Elecrow-RD/CrowPanel-Advanced-9inch-ESP32-P4-HMI-AI-Display-1024x600-IPS-Touch-Screen/3D file/ESP32-P4-9_0-inch-20251230.stp

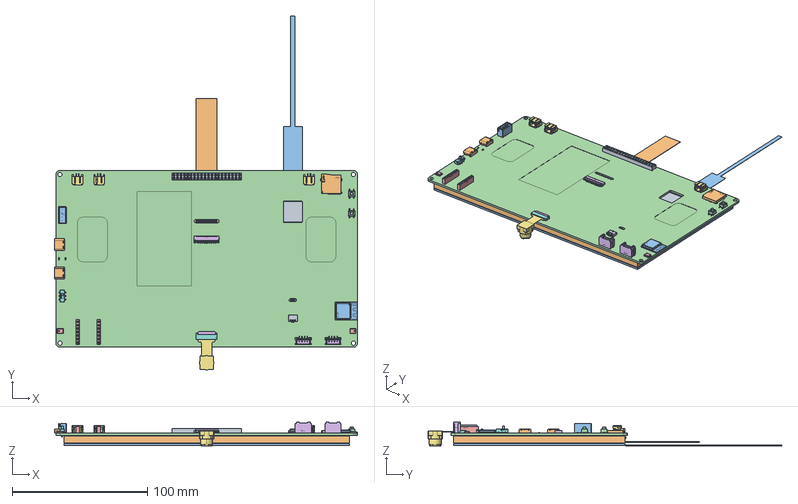
[picture p23: CAD file, 2026-01-28]
3D file/ESP32-P4-9_0-inch-20251230.stp
223.7 x 261.2 x 17.5 mm
LCD-9CUN
TP-9CUN
PCBA-9CUN
FPC1_FPC-SMD_P0_50-24P_QCHF-SM
H1_HDR-SMD_40P-P2_54-V-F-R2-C20
USB-C-SMD_TYPE-C-6PIN-2MD x 2
CN2_CONN-TH_4P-P2_50_4PIN_CONN
LED x 2
HDR-SMD_7P-P2_54_HX-PM2_54-1X7P x 2
U4_CONN-SMD_4P-P2_00 x 2
CONN-SMD_2P-P2_00_BX-PH2_0-2PWT x 3
SW-SMD_MST22D18G2_SW-SMD_MST22D
FPC-SMD_P0_50-6P_QCHF-SM-H2_0_1
TF-SMD
WIFIM-SMD_61P-L16_6-W13_2-P0_80
SW-SMD_4P-L4_5-W4_5-P3_00 x 2
MIC-SMD_6P-L4_7-W3_8-P1_65-TL_M x 2
CONN-SMD_AFC24-S30FIC-00_CONN-S
AS-AG638A32M1-25
