Elecrow-RD/CrowPanel-Advanced-9inch-ESP32-P4-HMI-AI-Display-1024x600-IPS-Touch-Screen/example/V1.2/Upgrade P4 to C6 firmware/CrowPanel_Advance_ESP32-P4 Display_Firmware_Upgrade_Guide-ESP_IDF platform.pdf

## Tutorial on Upgrading the C6 Firmware

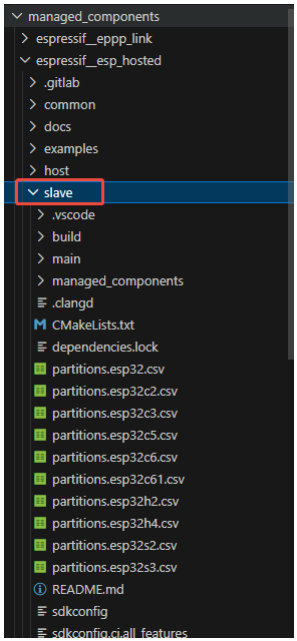
[picture p24: figure]

After compilation, a default network_adapter.bin file is generated in the build folder.

## via P4

First, select a version of the Hosted component. Here, we’ll choose version V2.12.3. The “slave” folder within the component contains the slave project. After selecting the ESP32-C6 chip, you can proceed to compile.

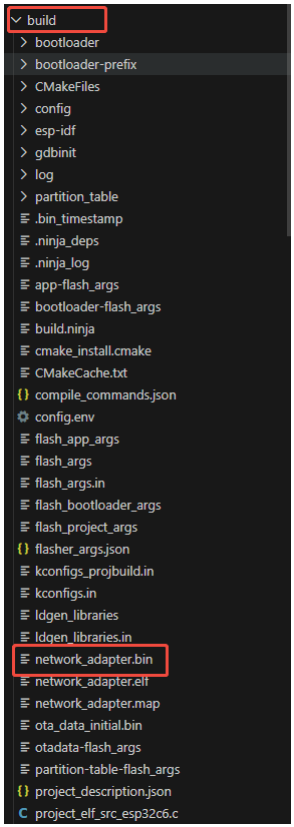
[picture p25: figure]

The 'host_performs_slave_ota' folder in the Hosted component is the OTA update project for the P4.

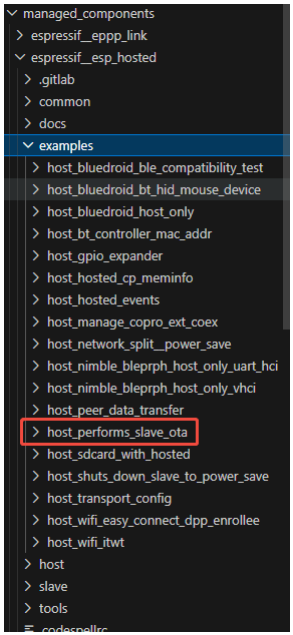
[picture p26: figure]

Add the following content to the 'sdkconfig.defaults' folder in the 'host_performs_slave_ota' project. Compile after modifying the default Hosted configuration. If the 'sdkconfig' file has already been generated, you can also make changes in 'menuconfig'.

# P4 chip version select

CONFIG_ESP32P4_SELECTS_REV_LESS_V3=y

# Host Slave OTA config

CONFIG_OTA_METHOD_LITTLEFS=y

CONFIG_ESP_HOSTED_PRIV_SDIO_PIN_CLK_SLOT_1=18 CONFIG_ESP_HOSTED_PRIV_SDIO_PIN_D0_SLOT_1=17 CONFIG_ESP_HOSTED_PRIV_SDIO_PIN_D1_4BIT_BUS_SLOT _1=16
CONFIG_ESP_HOSTED_PRIV_SDIO_PIN_D2_4BIT_BUS_SLOT _1=15
CONFIG_ESP_HOSTED_PRIV_SDIO_PIN_D3_4BIT_BUS_SLOT _1=14
CONFIG_ESP_HOSTED_SDIO_GPIO_RESET_SLAVE=32 5inch V1.0
CONFIG_ESP_HOSTED_SDIO_SLOT_1=y CONFIG_ESP_HOSTED_SDIO_4_BIT_BUS=y

Pin assignments vary by hardware version # Hosted slave config

7、9、10.1inch V1.0

CONFIG_ESP_HOSTED_SDIO_1_BIT_BUS=y CONFIG_ESP_HOSTED_SDIO_BUS_WIDTH=1 CONFIG_ESP_HOSTED_SDIO_CLOCK_FREQ_KHZ=40000 CONFIG_ESP_HOSTED_PRIV_SDIO_PIN_CMD_SLOT_1=19 CONFIG_ESP_HOSTED_PRIV_SDIO_PIN_CLK_SLOT_1=18 CONFIG_ESP_HOSTED_PRIV_SDIO_PIN_D0_SLOT_1=14 CONFIG_ESP_HOSTED_PRIV_SDIO_PIN_D1_1BIT_BUS_SLOT _1=15
CONFIG_ESP_HOSTED_SDIO_GPIO_RESET_SLAVE=32

7、9、10.1inch V1.1

CONFIG_ESP_HOSTED_SDIO_SLOT_1=y CONFIG_ESP_HOSTED_SDIO_4_BIT_BUS=y CONFIG_ESP_HOSTED_SDIO_CLOCK_FREQ_KHZ=40000 CONFIG_ESP_HOSTED_PRIV_SDIO_PIN_CMD_SLOT_1=19

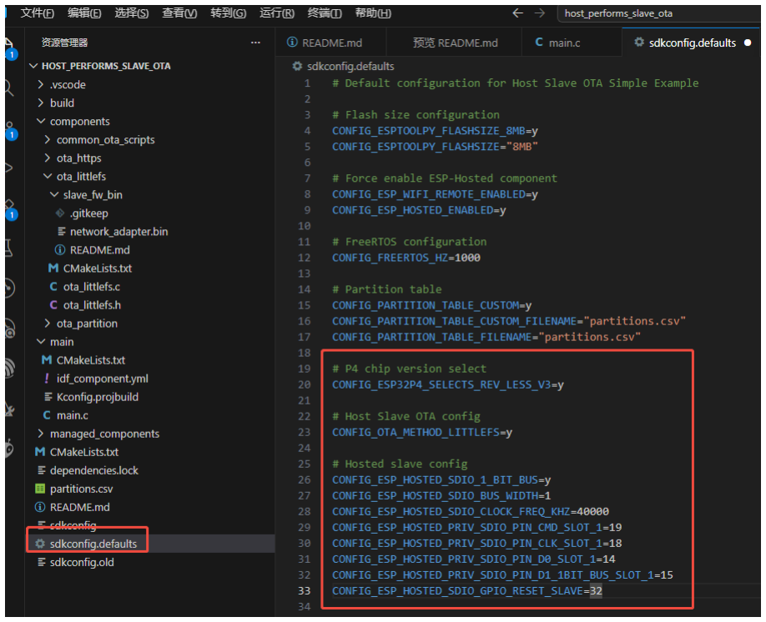
[picture p27: figure]

Place the network_adapter.bin firmware generated by the slave
project | into | the | corresponding | folder | in | the
host_performs_slave_ota project.

CONFIG_ESP_HOSTED_SDIO_CLOCK_FREQ_KHZ=40000 CONFIG_ESP_HOSTED_PRIV_SDIO_PIN_CMD_SLOT_1=54 CONFIG_ESP_HOSTED_PRIV_SDIO_PIN_CLK_SLOT_1=53 CONFIG_ESP_HOSTED_PRIV_SDIO_PIN_D0_SLOT_1=52 CONFIG_ESP_HOSTED_PRIV_SDIO_PIN_D1_4BIT_BUS_SLOT _1=51
CONFIG_ESP_HOSTED_PRIV_SDIO_PIN_D2_4BIT_BUS_SLOT _1=50
CONFIG_ESP_HOSTED_PRIV_SDIO_PIN_D3_4BIT_BUS_SLOT _1=49
CONFIG_ESP_HOSTED_SDIO_GPIO_RESET_SLAVE=20

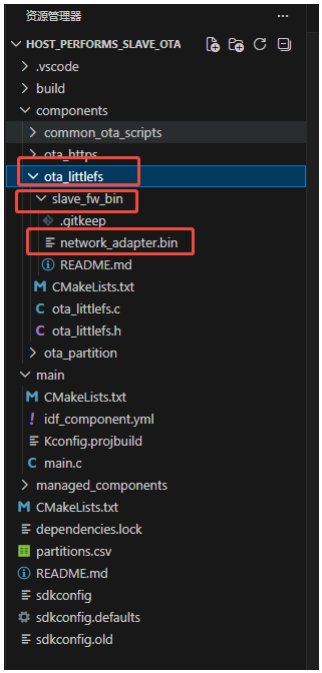
[picture p28: figure]

After | that, | select | the | ESP32-P4 | chip, | compile | the
host_performs_slave_ota project, and upload it to the ESP32-P4 Advance Board. Once the program runs, it will perform an OTA update of the C6 firmware.

Regarding the 1-bit and 4-bit options:

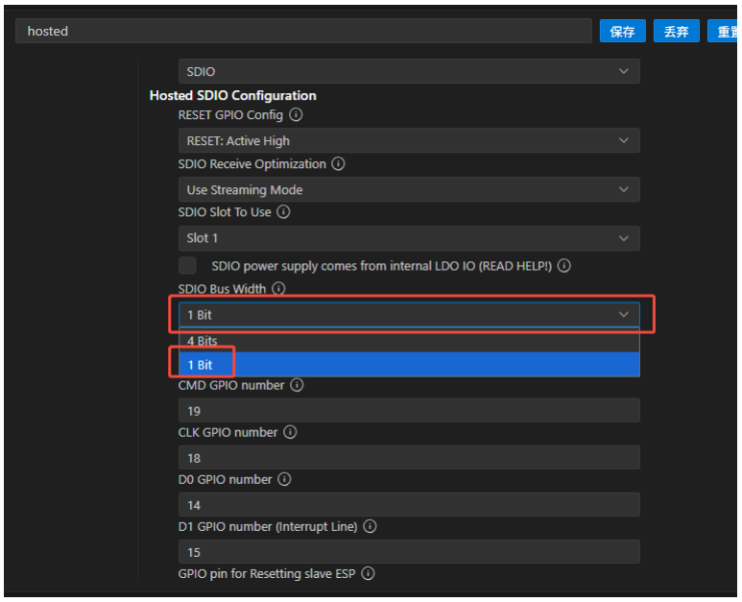
[picture p29: figure]
