Elecrow-RD/CrowPanel-Advanced-9inch-ESP32-P4-HMI-AI-Display-1024x600-IPS-Touch-Screen/Eagle_SCH&PCB/1.1/ESP32-P4 Display 9.0 inch V1.1.pdf

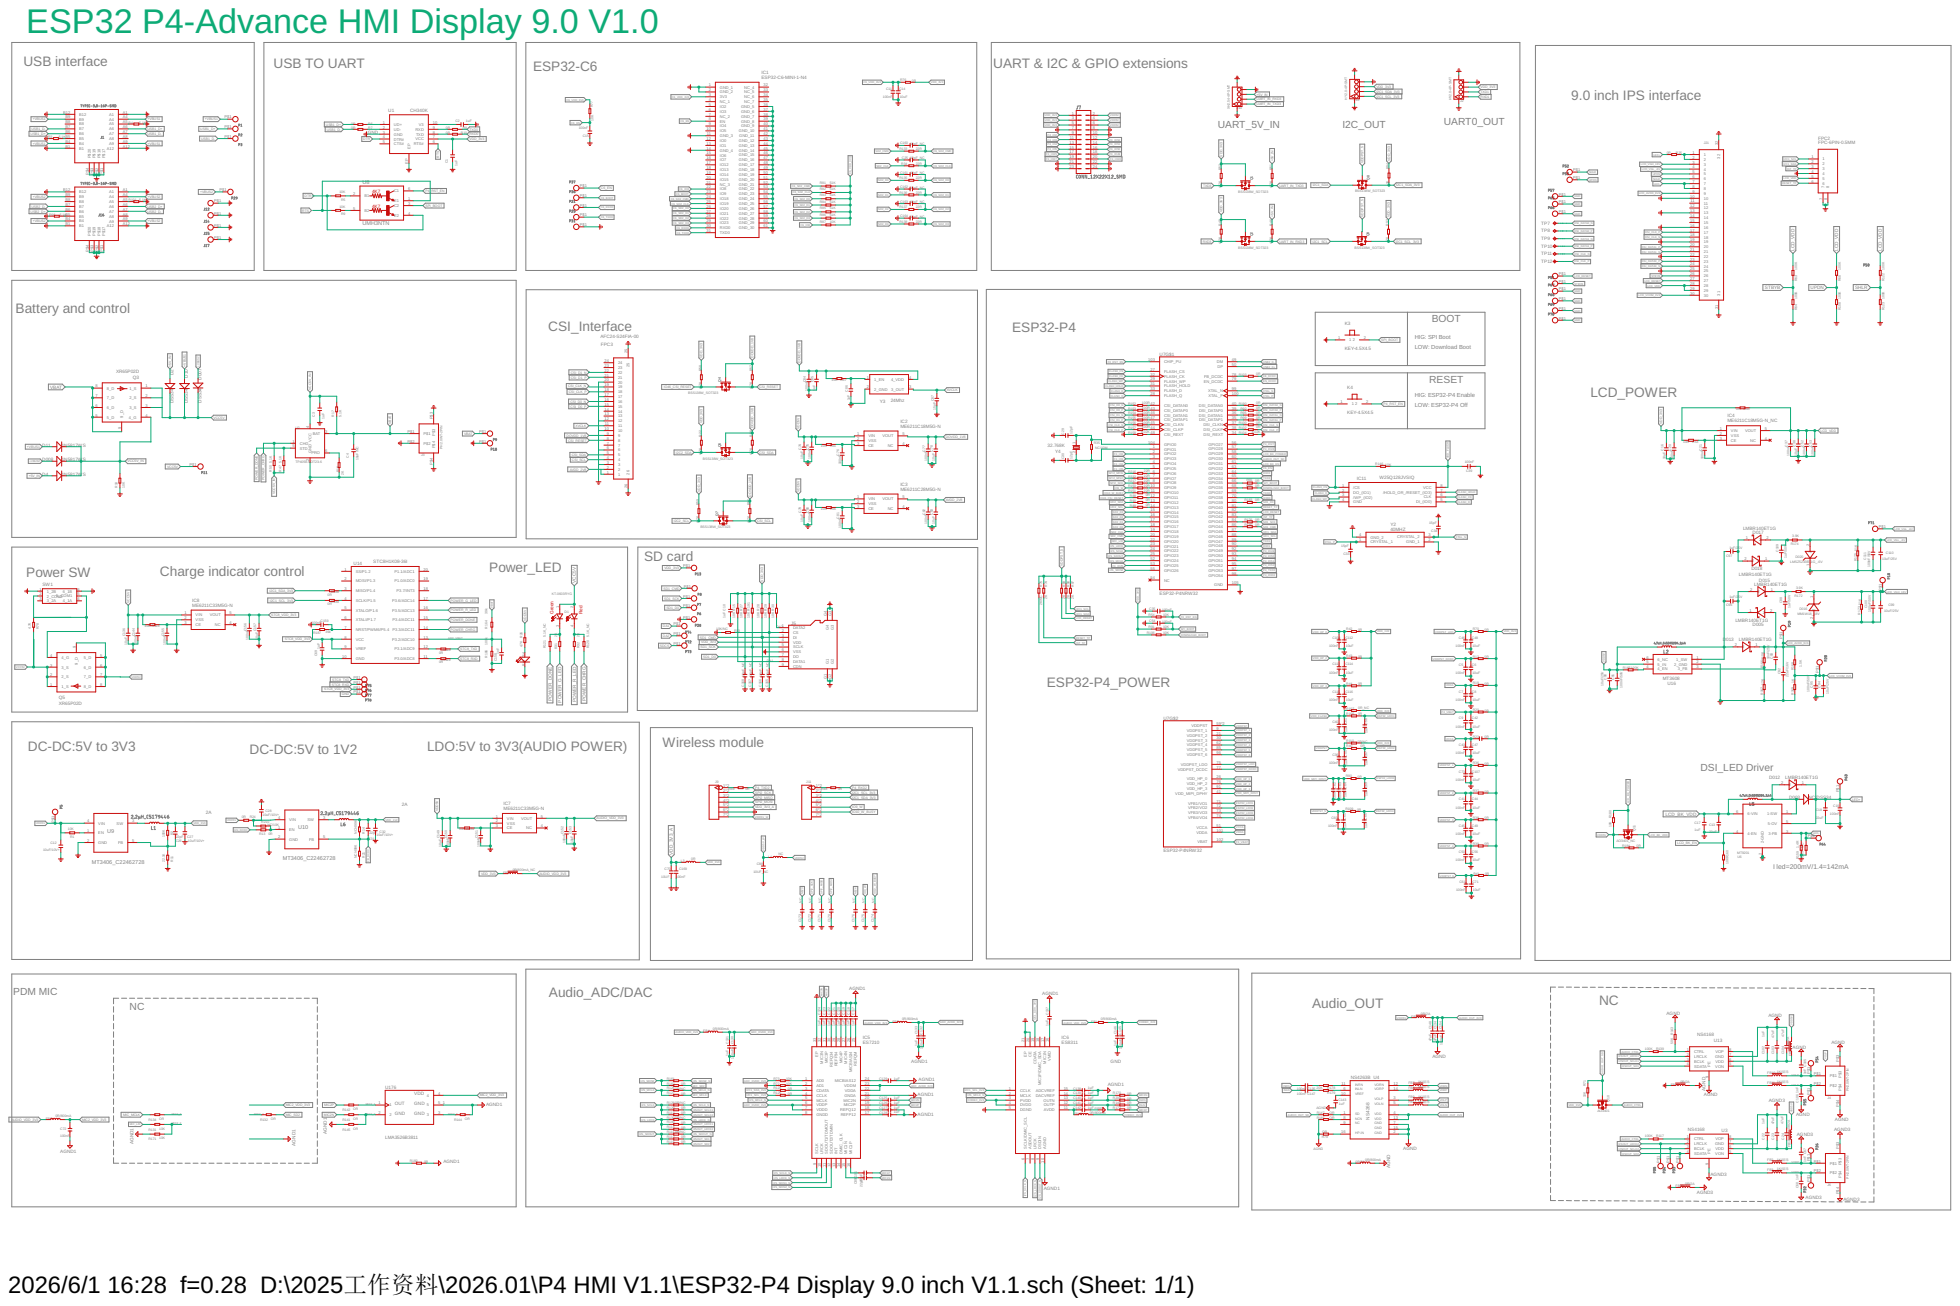
[picture p32: page 1]

HIG: SPI Boot LOW: Download Boot HIG: ESP32-P4 Enable

LDO:5V to 3V3(AUDIO POWER)

2026/6/1 16:28 f=0.28 D:\2025工作资料\2026.01\P4 HMI V1.1\ESP32-P4 Display 9.0 inch V1.1.sch (Sheet: 1/1)
