Elecrow-RD/CrowPanel-Advanced-9inch-ESP32-P4-HMI-AI-Display-1024x600-IPS-Touch-Screen/Eagle_SCH&PCB/1.2/ESP32-P4 Display 9.0 inch V1.2.pdf

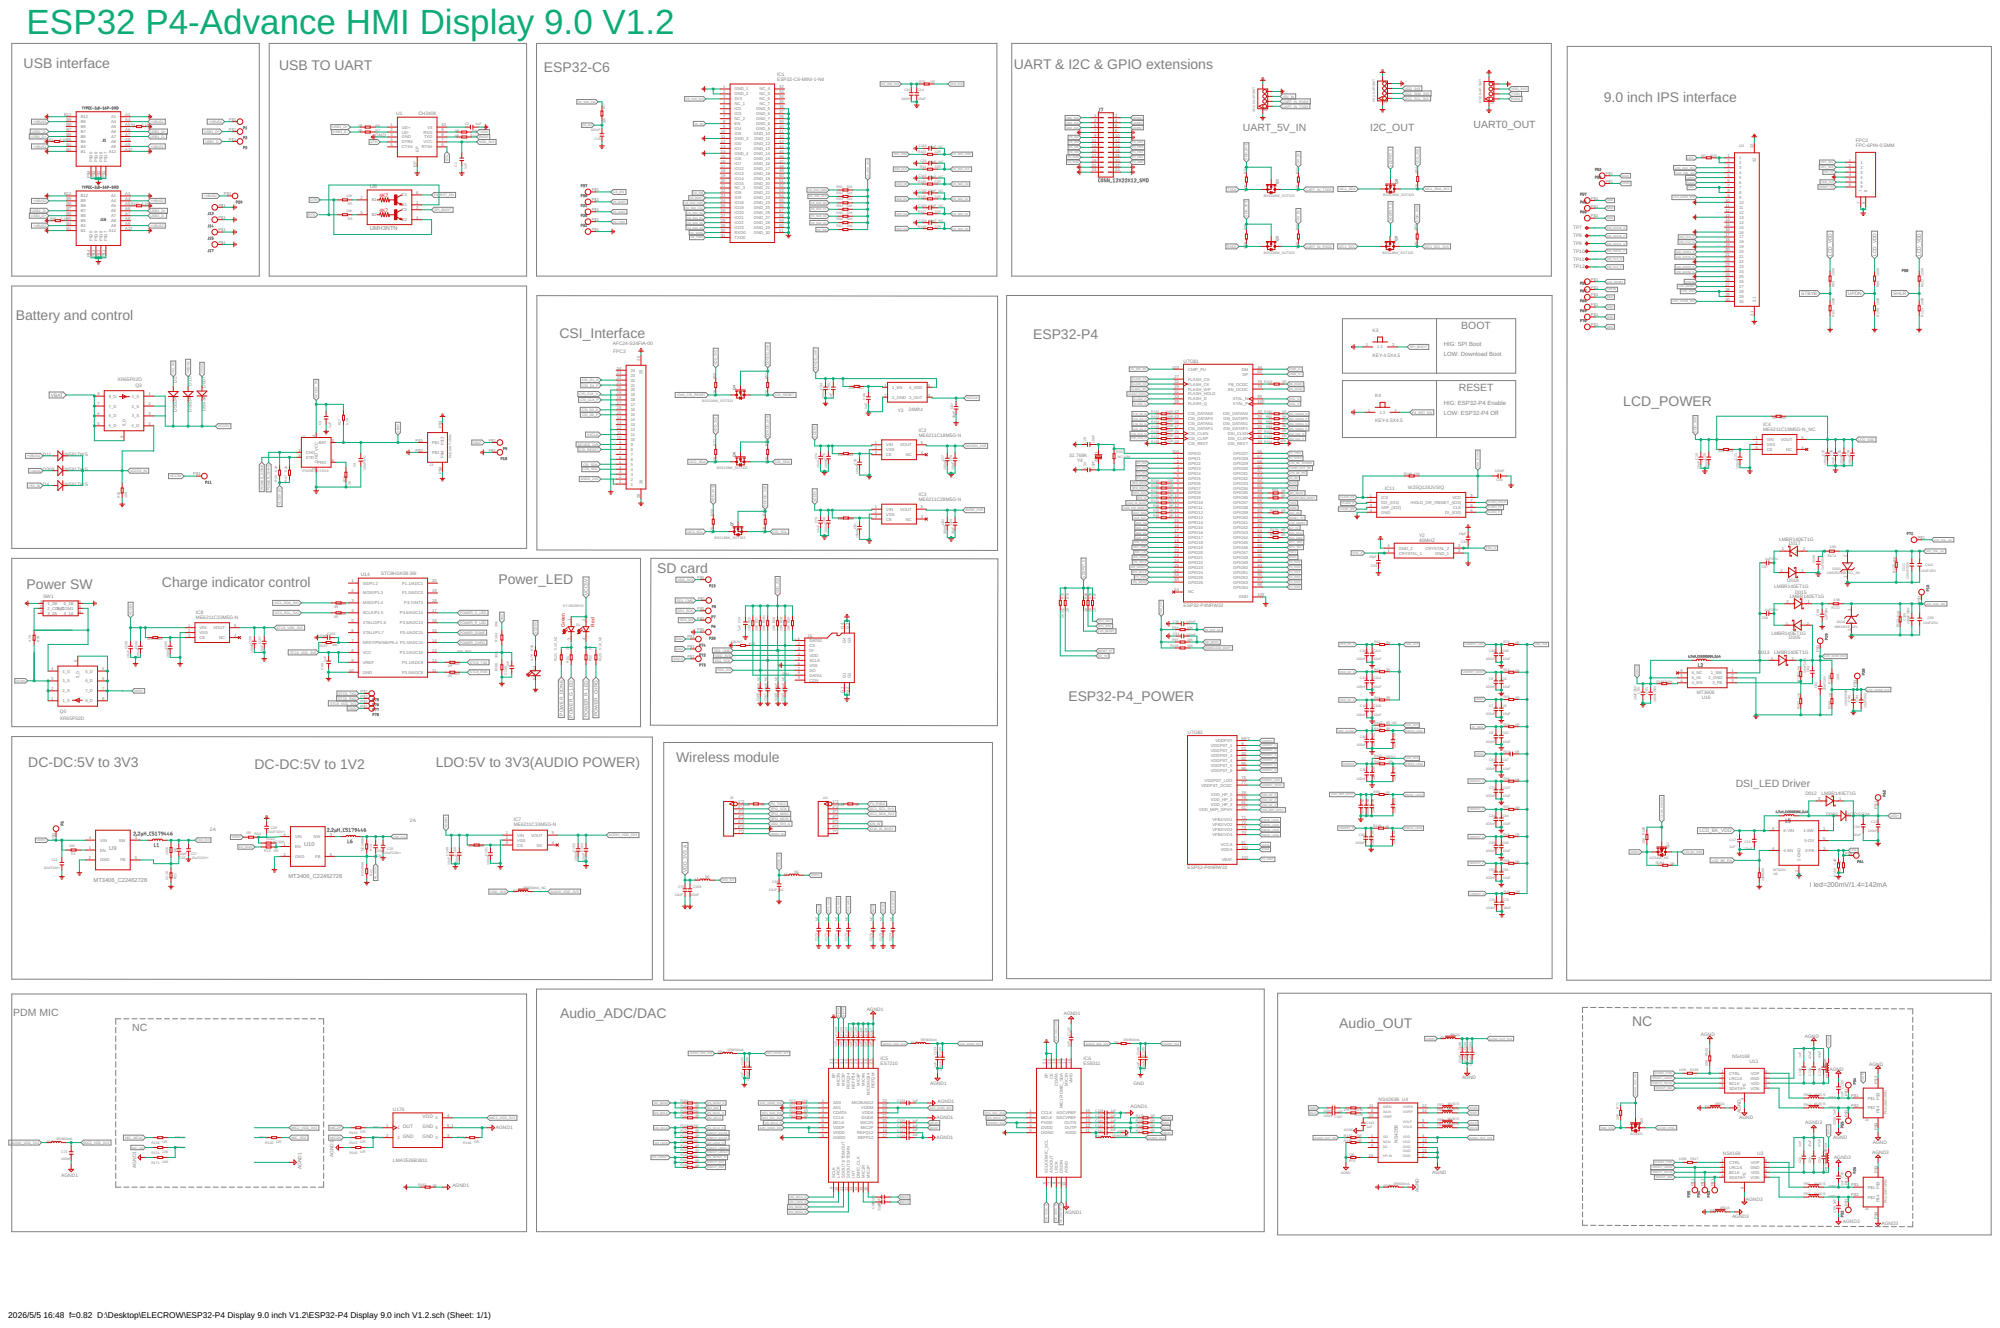
[picture p33: page 1]

LDO:5V to 3V3(AUDIO POWER)

2026/5/5 16:48 f=0.82 D:\Desktop\ELECROW\ESP32-P4 Display 9.0 inch V1.2\ESP32-P4 Display 9.0 inch V1.2.sch (Sheet: 1/1)
