Elecrow-RD/CrowPanel-Advanced-9inch-ESP32-P4-HMI-AI-Display-1024x600-IPS-Touch-Screen/Eagle_SCH&PCB/1.0/ESP32-P4 Display 9.0 inch V1.0-PDF.pdf

UART_5V_IN | I2C_OUT | UART0_OUT

### CH340K

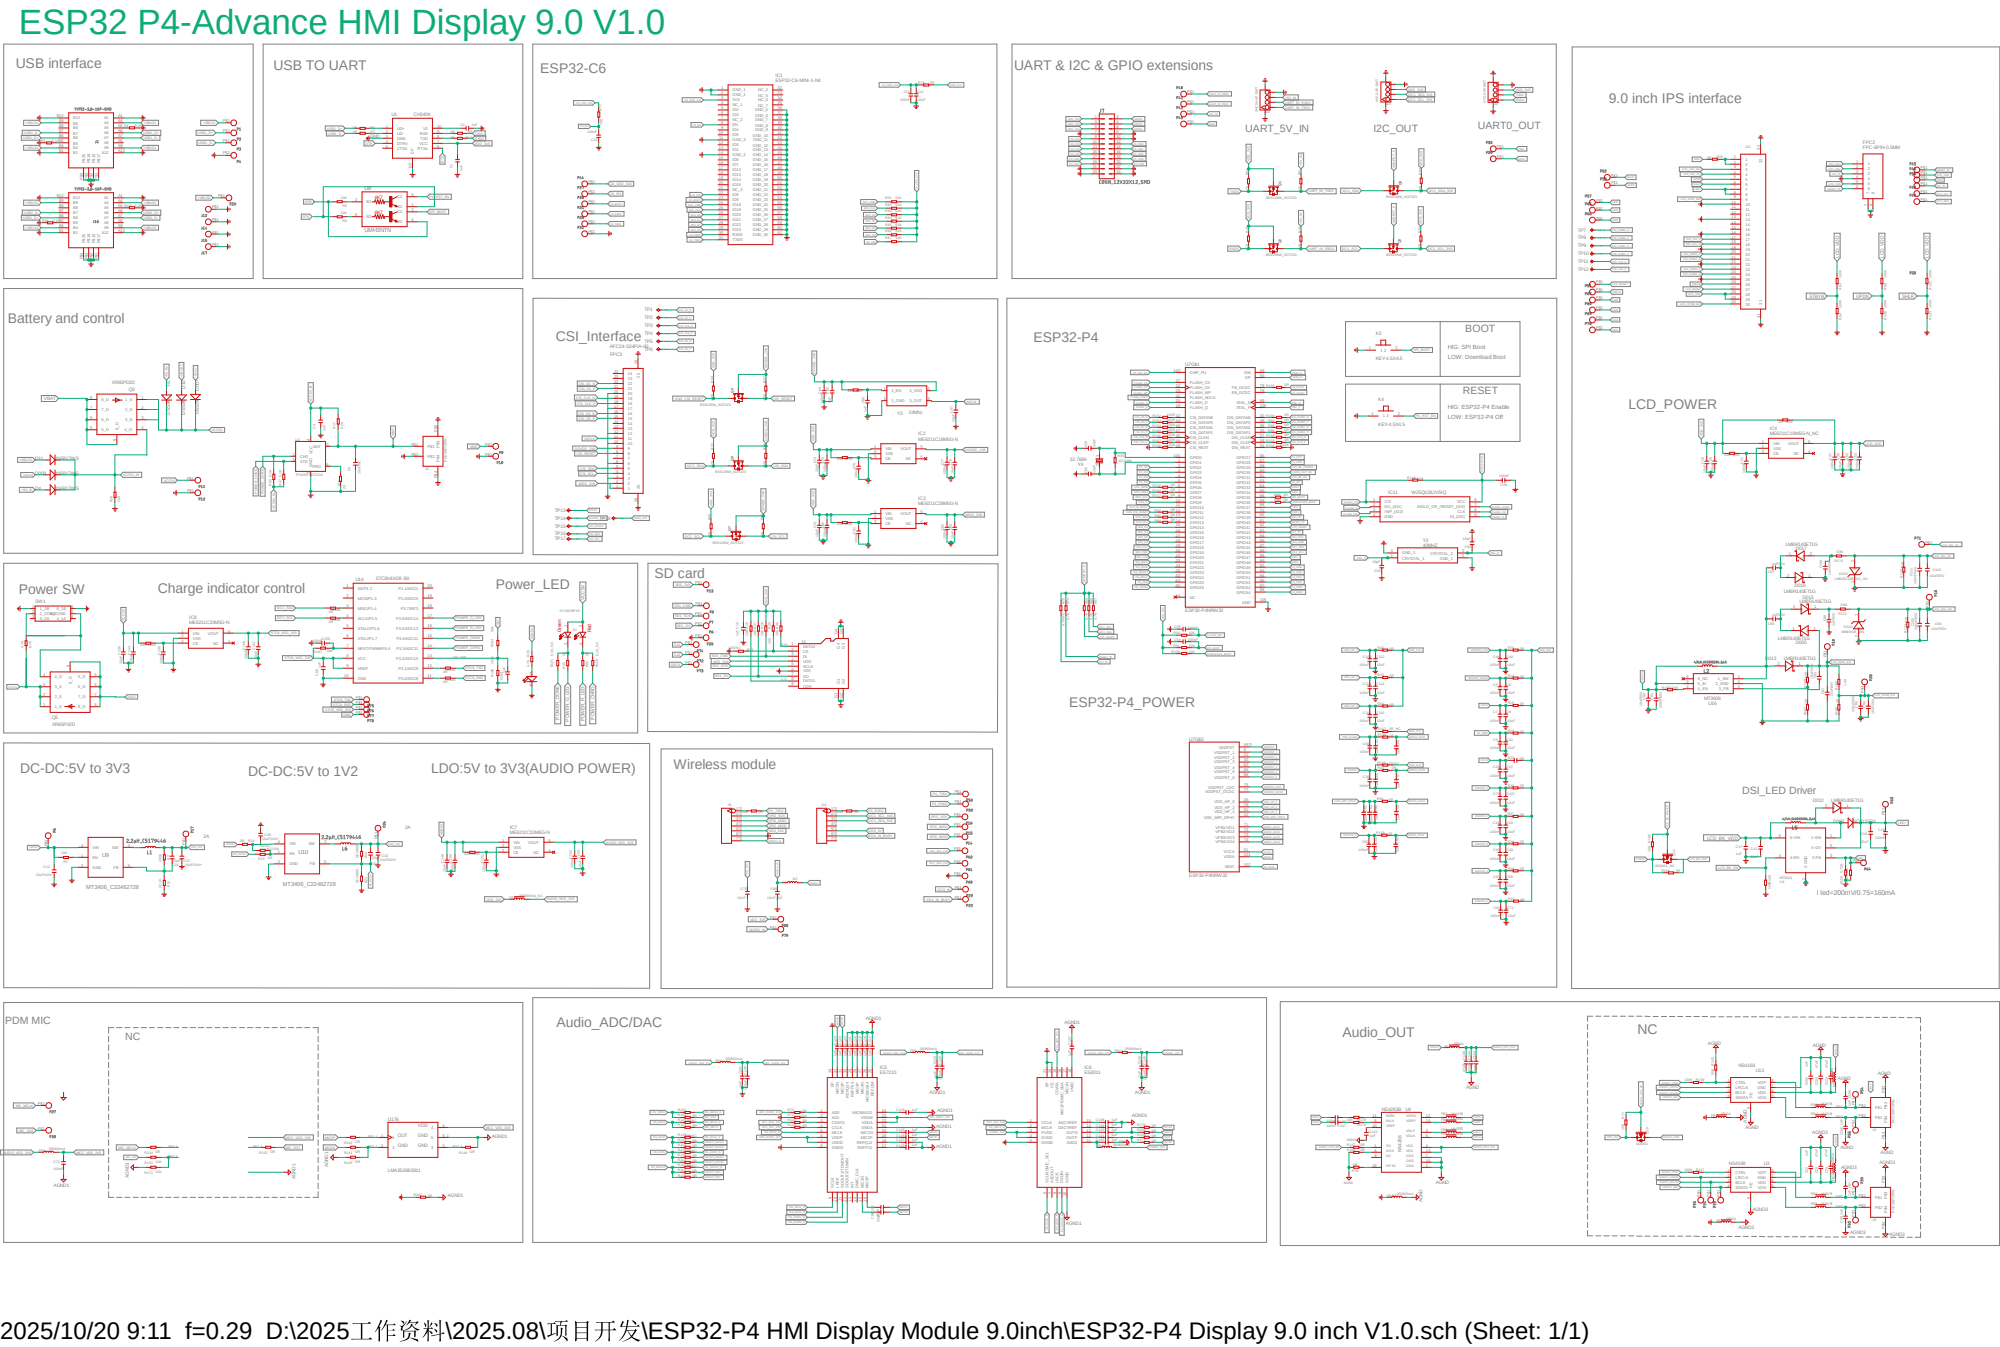
[picture p34: page 1]

LDO:5V to 3V3(AUDIO POWER)
