Elecrow-RD/CrowPanel-Advanced-9inch-ESP32-P4-HMI-AI-Display-1024x600-IPS-Touch-Screen/(commit log)

2026-03-18 add arduino
2026-05-12 sync idf lesson13
    [partitions.csv]
2026-06-04 sync example/V1.1 V1.2
    [partitions.csv]
